Alhussein-Ayad/carsec-dashboard/CarAntiTheftSystem.pptx

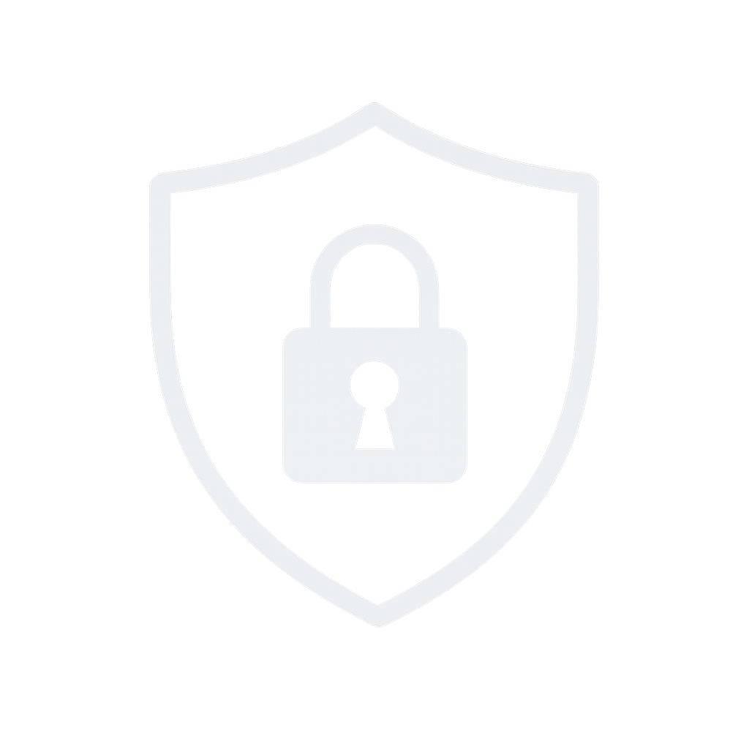
[picture p1: figure]

Car Anti-Theft System

STM32 + FreeRTOS | IoT Security Solution

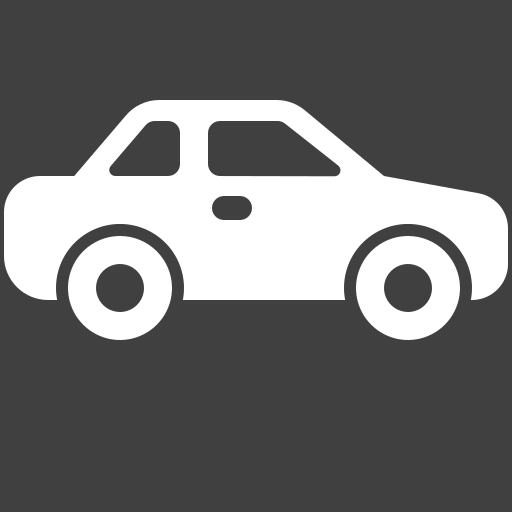
[picture p2: figure]

Team Members:
Alhussein Aly Ayad 221004147
Shapinam Abdelfattah Hassan 221004292
Seif-El din Tarek Ismail 221006919 Mohamed Tamer Taimor 221004807
Hanya Essam Abdelfattah 221006161 Supervisor : Dr Amr Fahmy

Notes: [SPEAKER 1 — Alhussein Aly Ayad | Slide 1: Title]
Good morning everyone. Our project is the Car Anti-Theft System — a multi-layered embedded security solution built on the STM32F401 microcontroller, powered by FreeRTOS, and extended with GPS, GSM, and an ESP32 web interface.
My name is Alhussein, and together with my teammate Shapinam, we'll start by covering the problem and our solution concept.

## Slide 2

Problem Statement

Distance Limitations

Standard local alarms ignore easily alarms. If the owner is far away, they receive no notification of a breach.

No Real-Time Alerts

Owners remain unaware of break-ins
or unauthorized access attempts

No Tracking

Once stolen, vehicles are hard to locate
without embedded GPS solutions

Internet Dependency

Smart car apps require Wi-Fi or mobile data leaving the car completely vulnerable in network dead zones.


Notes: [SPEAKER 1 — Alhussein Aly Ayad | Slide 2: Problem Statement]
Standard car security systems have four critical failures:
First — Distance Limitations: local alarms are easily ignored and owners far away get no notification.
Second — No Real-Time Alerts: break-ins or unauthorized access happen without the owner knowing.
Third — No Tracking: once a vehicle is stolen, there is no way to locate it without an embedded GPS.
Fourth — Internet Dependency: smart car apps completely fail in network dead zones.
These four gaps are exactly what our system is designed to solve.

## Slide 3

Proposed Solution

A Multi-layered embedded security system combining hardware sensors,
wireless communication, and a remote web interface which is a dual communication channels.

STM32 + FreeRTOS

Central controller with real-time multitasking

RFID Authorization

Key-based access using MFRC522 scanner

Multi-Sensor Alarm

Reed switch + vibration + buzzer + LED


GPS Tracking

Live coordinates via GPS module

GSM Alerts

Offline SMS alerts to owner's phone

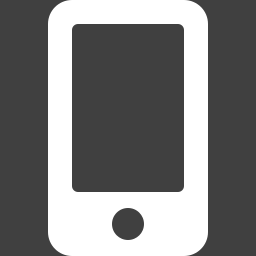
[picture p5: figure]

ESP32 Web Interface

Remote arm/disarm & monitoring via browser

Notes: [SPEAKER 1 — Alhussein Aly Ayad | Slide 3: Solution Overview]
Our solution is a multi-layered embedded security system with two independent communication channels — GSM for offline SMS alerts and ESP32 for remote web access.
The six pillars are:
1. STM32 + FreeRTOS as the real-time processing core
2. RFID for key-based access control
3. A multi-sensor alarm using reed switch, vibration sensor, buzzer, and LED
4. GPS for live coordinate tracking
5. GSM for offline SMS alerts that work without internet
6. And an ESP32 web dashboard for remote monitoring from any device
I'll now hand over to Shapinam to explain the hardware specifications.

## Slide 4

System Architecture

ESP32
Web Interface

RFID
MFRC522

H-Bridge
DC Motor


STM32F401
+ FreeRTOS

Reed Switch
Door Sensor

Buzzer +
LED Alarm

Vibration
Sensor

GPS + GSM
Modules

LCD
Display

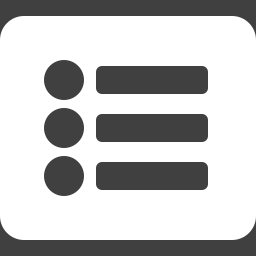
[picture p7: figure]

Notes: [SPEAKER 3 — Seif-El Din Tarek Ismail | Slide 6: System Architecture]
Here is the complete system architecture.
The STM32F401 with FreeRTOS is the central controller. It interfaces directly with:
- RFID MFRC522 for access
- Reed switch for door monitoring
- Vibration sensor for perimeter security
- H-Bridge and DC motor for engine control
- Buzzer and LEDs for the alarm
- GPS and GSM modules via UART
- And the 16x2 I2C LCD for local status display
The ESP32 sits alongside and independently hosts the remote web interface.
I'll now hand over to Mohamed to explain the firmware logic and connectivity.

## Slide 5

Work Steps & Outcomes

01

Requirements & Design

→

Component list, system block diagram, GPIO map, security scenarios, and communication requirements

02

Hardware Assembly

→

Wired & tested all sensors/actuators on breadboard

03

FreeRTOS Firmware

→

Tasks for RFID, sensors, GSM/GPS, LCD running concurrently

04

ESP32 Web Interface

→

HTML dashboard deployed with public URL, with remote arm/disarm, GPS display, and live alert feed

05

Integration & Testing

→

Full end-to-end scenario testing (auth, alarm, GPS, SMS)

06

Final Demo & Report

→

Live demonstration(Car Maquet), GitHub repo, documentation complete

Notes: [SPEAKER 5 — Hanya Essam Abdelfattah | Slide 10: Project Journey]
Our project went through six structured phases:
Phase 1 — Requirements & Design: component list, block diagram, GPIO mapping, and communication scenarios.
Phase 2 — Hardware Assembly: wired and tested all sensors and actuators on a breadboard.
Phase 3 — FreeRTOS Firmware: concurrent tasks for RFID, sensors, GPS/GSM, and the LCD.
Phase 4 — ESP32 Web Interface: HTML dashboard deployed with a public URL.
Phase 5 — Integration & Testing: full end-to-end scenario testing covering authentication, alarm, GPS, and SMS.
Phase 6 — Final Demo & Report: live car maquet demonstration, GitHub repository, and complete documentation.
Thank you for following our journey.

## Slide 6

Core Hardware & Specs

Component | Details
Main Controller | STM32F401 Black Pill @ 84 MHz
RTOS | FreeRTOS -> concurrent task scheduling
RFID Module | MFRC522 —> SPI interface
Motor Driver | H-Bridge(12v) —> DC motor (5v)
Alarm | Active buzzer
Door Sensor | Magnetic reed switch
Vibration Sensor | SW-420 vibration sensor module
GPS Module | NEO-6M GPS module —> UART
GSM Module | SIM800L —> SMS alerts —> UART
Display | 16×2 LCD — I2C
Web Interface MCU | ESP32 — HTML web UI, public URL
Power Supply | 12V DC → 5V / 3.3V

Notes: [SPEAKER 2 — Shapinam Abdelfattah Hassan | Slide 4: Core Hardware & Specs]
My name is Shapinam, and I'll cover the hardware foundation of our system.
The brain is the STM32F401 Black Pill running at 84 MHz, supported by FreeRTOS for concurrent task execution.
Key interfaces include: RFID via SPI, GPS and GSM via UART, and the LCD via I2C.
The H-Bridge accepts 12V input and drives a 5V DC motor for engine simulation.
Power is stepped down from 12V DC to 5V and 3.3V to supply all components.
I'll now hand to Seif to explain how the physical security layer is built.

## Slide 7

Physical Security Perimeter

RFID Access Control

MFRC522 scanner via SPI: authorized cards unlock normally; unauthorized cards trigger immediate buzzer alarm

Magnetic Reed Switch

Door sensor detects any unauthorized opening attempt and instantly activates the alarm system

SW-420 Vibration Sensor

Detects window-break and forced-entry attempts — provides full perimeter coverage beyond just the door

Active Buzzer + LEDs

Immediate local alarm on any breach — audible buzzer and visual LED indicator for rapid deterrence

Notes: [SPEAKER 3 — Seif-El Din Tarek Ismail | Slide 5: Physical Security Perimeter]
My name is Seif, and I'll walk you through the physical security layer.
The MFRC522 RFID scanner via SPI handles access control — authorized cards grant entry, unauthorized ones immediately trigger the alarm.
A magnetic reed switch on the door detects any unauthorized opening attempt.
The SW-420 vibration sensor covers window-break and forced-entry scenarios, extending the perimeter beyond the door.
Finally, an active buzzer and LED provide instant audible and visual alerts on any breach.
Next I'll show you how all of these components connect in the system architecture.

## Slide 8

FreeRTOS Firmware & Engine Control

FreeRTOS Task Architecture

Concurrent task scheduling ensures RFID, sensors, GPS/GSM, and LCD modules all run simultaneously without blocking

RFID Authorization Logic

Authorized cards: normal access granted. Unauthorized cards: alarm triggers immediately via buzzer and LED

Engine Start Control

Push button activates engine via 12V H-Bridge controlling a 5V DC motor — only available after valid RFID authorization

LCD Status Display

16x2 I2C LCD reflects live system state transitions Armed, Disarmed, Alarm Active, Engine On for local debugging

Notes: [SPEAKER 4 — Mohamed Tamer Taimor | Slide 7: FreeRTOS Firmware & Engine Control]
My name is Mohamed, and I'll cover the firmware layer on the STM32.
FreeRTOS enables fully concurrent task scheduling — RFID, sensors, GPS/GSM, and LCD tasks all run simultaneously without any blocking.
For authorization: an authorized RFID card grants access normally; an unauthorized card instantly triggers the alarm.
Engine control uses a push button that activates the H-Bridge to start the DC motor — this is only possible after a successful RFID authorization.
The 16x2 I2C LCD provides live state feedback showing Armed, Disarmed, Alarm Active, and Engine On states.
Next I'll cover the connectivity layer.

## Slide 9

Connectivity: GPS, GSM & ESP32 Dashboard

NEO-6M GPS Module

Retrieves live vehicle coordinates via UART

SIM800L GSM Module

Sends real-time SMS alerts directly to the owner's phone via UART fully offline, no Wi-Fi required

ESP32 Web Interface

Hosts an HTML dashboard accessible from any device via a public URL for remote arm/disarm and GPS viewing

Dual-Channel Design

GSM handles offline emergencies; ESP32 handles remote monitoring two independent channels for maximum reliability

Notes: [SPEAKER 4 — Mohamed Tamer Taimor | Slide 8: Connectivity: GPS, GSM & ESP32 Dashboard]
The connectivity layer has two independent channels, which is what makes this system robust.
The NEO-6M GPS module retrieves live vehicle coordinates over UART — this works entirely offline.
The SIM800L GSM module sends real-time SMS alerts directly to the owner's phone via UART — no Wi-Fi, no mobile data app required.
The ESP32 hosts an HTML dashboard accessible from any network via a public URL — allowing the owner to arm or disarm the system and view GPS coordinates remotely.
This dual-channel design ensures the owner is always reachable: GSM handles emergency alerts offline, ESP32 handles full remote control when internet is available.
I'll now hand over to Hanya to present our results.

## Slide 10

Achievements & Results

Fully functional RFID-based access control: authorized/unauthorized detection working

FreeRTOS multi-task architecture: all modules run concurrently without blocking

Real-time GPS coordinates: retrieved and forwarded via to owner phone

Vibration & reed switch: alarms triggering correctly with <200ms response time

ESP32 web dashboard: live on public URL — arm/disarm & GPS view from any device

LCD: debug display correctly reflecting all system state transitions

Complete integration test: door breach → alarm → SMS alert → remote disarm cycle

Notes: [SPEAKER 5 — Hanya Essam Abdelfattah | Slide 9: Achievements & Results]
My name is Hanya, and I'm proud to present our final results.
RFID access control is fully working — authorized and unauthorized cards are reliably distinguished.
FreeRTOS keeps all modules running concurrently without any blocking.
Vibration and reed switch alarms respond in under 200 milliseconds.
Real-time GPS coordinates are retrieved and forwarded to the owner's phone via SMS.
The ESP32 dashboard is live on a public URL — arm, disarm, and GPS view work from any device.
The LCD correctly reflects all system state transitions.
Most importantly, we completed a full integration test cycle: Door breach detected → Alarm triggered → SMS alert sent → Remote disarm via the ESP32 dashboard.

## Slide 11

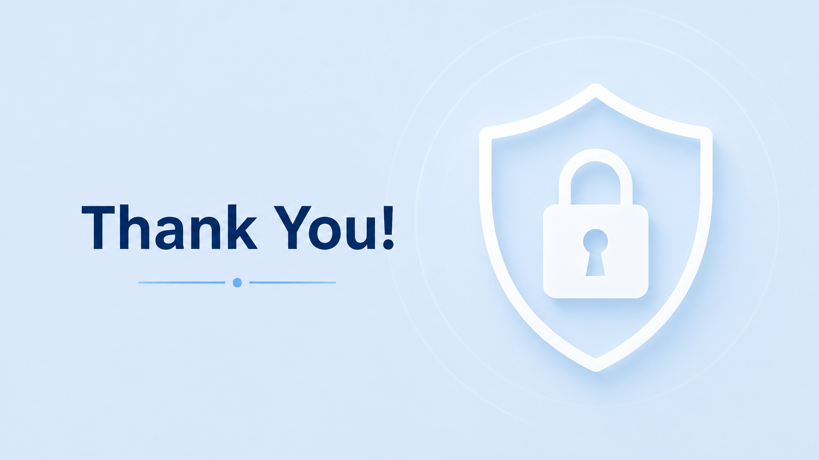
[picture p8: figure]

Notes: [ALL SPEAKERS]
Thank you for your attention.
Our Car Anti-Theft System demonstrates a complete, real-world multi-layered embedded security solution integrating hardware, real-time firmware, and IoT connectivity.
We are happy to take any questions. Thank you to our supervisor, Dr. Amr Fahmy, for his guidance throughout this project.
